Leinka1056/alkine/BOM.md

# alkine - a versatile esp32 dev board – bill of materials

<!-- Generated by Half Life from project cmuv02fvs0c1101sm7iym0ofc. Edits here are overwritten on the next sync. -->
<!-- Generated: 2026-10-11T17:37:29.527Z -->

> [!NOTE]
> This parts list is mirrored from [Half Life](https://halflife.hackclub.com). Editing it here will not change the platform's copy, and the next sync overwrites this file.

| Week | Tier | Parts funding |
| --- | --- | --- |
| Week 1 | Tier 2 | $65.00 |

| Part | What it's for | Qty | Unit | Total | Vendor |
| --- | --- | --- | --- | --- | --- |
| [ESP32-C6-WROOM-1U](https://www.digikey.co.uk/en/products/detail/espressif-systems/ESP32-C6-WROOM-1U-N8/20685870) | main processor | 2 | $5.57 | $11.14 | [digikey](https://www.digikey.co.uk/en/products/detail/espressif-systems/ESP32-C6-WROOM-1U-N8/20685870) |
| [usb c receptacle](https://www.digikey.co.uk/en/products/detail/gct/USB4085-GF-A/9859662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) | usb communication and charging | 2 | $0.91 | $1.82 | [digikey](https://www.digikey.co.uk/en/products/detail/gct/USB4085-GF-A/9859662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) |
| [XC6210B332MR](https://www.digikey.co.uk/en/products/detail/torex-semiconductor-ltd/XC6210B332MR-G/2138119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) | Linear Voltage Regulator IC | 2 | $0.78 | $1.56 | [digikey](https://www.digikey.co.uk/en/products/detail/torex-semiconductor-ltd/XC6210B332MR-G/2138119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) |
| [MCP73871](https://www.digikey.co.uk/en/products/detail/microchip-technology/MCP73871-2CCI-ML/1680971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) | LiPo regulator | 2 | $2.41 | $4.82 | [digikey](https://www.digikey.co.uk/en/products/detail/microchip-technology/MCP73871-2CCI-ML/1680971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) |
| [JS202011AQN](https://www.digikey.co.uk/en/products/detail/c-k/JS202011AQN/1640096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) | fast charge switch | 2 | $0.83 | $1.66 | [digikey](https://www.digikey.co.uk/en/products/detail/c-k/JS202011AQN/1640096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) |
| [CRCW12063K30FKEA](https://www.digikey.co.uk/en/products/detail/vishay-dale/CRCW12063K30FKEA/1176701) | 3.3K OHM resistor(s) | 2 | $0.11 | $0.22 | [digikey](https://www.digikey.co.uk/en/products/detail/vishay-dale/CRCW12063K30FKEA/1176701) |
| [CRCW12065K10FKEA](https://www.digikey.co.uk/en/products/detail/vishay-dale/CRCW12065K10FKEA/1176724) | 5.1K OHM resistor(s) | 4 | $0.11 | $0.44 | [digikey](https://www.digikey.co.uk/en/products/detail/vishay-dale/CRCW12065K10FKEA/1176724) |
| [CRCW12061K00FKEA](https://www.digikey.co.uk/en/products/detail/vishay-dale/CRCW12061K00FKEA/1176644) | 1K OHM resistor(s) | 2 | $0.11 | $0.22 | [digikey](https://www.digikey.co.uk/en/products/detail/vishay-dale/CRCW12061K00FKEA/1176644) |
| [CRCW120610K0FKEA](https://www.digikey.co.uk/en/products/detail/vishay-dale/CRCW120610K0FKEA/1176758) | 10K OHM resistor(s) | 4 | $0.11 | $0.44 | [digikey](https://www.digikey.co.uk/en/products/detail/vishay-dale/CRCW120610K0FKEA/1176758) |
| [CRCW120615K0FKEA](https://www.digikey.co.uk/en/products/detail/vishay-dale/CRCW120615K0FKEA/1176776) | 15K OHM resistor(s) | 4 | $0.11 | $0.44 | [digikey](https://www.digikey.co.uk/en/products/detail/vishay-dale/CRCW120615K0FKEA/1176776) |
| [CRCW12062K00FKEA](https://www.digikey.co.uk/en/products/detail/vishay-dale/CRCW12062K00FKEA/1176676) | 2K OHM resistor(s) | 2 | $0.11 | $0.22 | [digikey](https://www.digikey.co.uk/en/products/detail/vishay-dale/CRCW12062K00FKEA/1176676) |
| [CRCW1206470RFKEA](https://www.digikey.co.uk/en/products/detail/vishay-dale/CRCW1206470RFKEA/1176606) | 470 OHM resistor(s) | 6 | $0.11 | $0.66 | [digikey](https://www.digikey.co.uk/en/products/detail/vishay-dale/CRCW1206470RFKEA/1176606) |
| [298D106X0025A2T](https://www.digikey.co.uk/en/products/detail/vishay-sprague/298D106X0025A2T/21707090) | 10 µF capacitor(s) | 2 | $1.76 | $3.52 | [digikey](https://www.digikey.co.uk/en/products/detail/vishay-sprague/298D106X0025A2T/21707090) |
| [T491A475M016AT](https://www.digikey.co.uk/en/products/detail/kemet/T491A475M016AT/818560) | 4.7 µF capacitor(s) | 6 | $0.64 | $3.84 | [digikey](https://www.digikey.co.uk/en/products/detail/kemet/T491A475M016AT/818560) |
| [T491A226K010AT](https://www.digikey.co.uk/en/products/detail/kemet/T491A226K010AT/2336197) | 22 µF capacitor(s) | 2 | $0.97 | $1.94 | [digikey](https://www.digikey.co.uk/en/products/detail/kemet/T491A226K010AT/2336197) |
| [T491A104K035AT](https://www.digikey.co.uk/en/products/detail/kemet/T491A104K035AT/818537) | 0.1 µF capacitor(s) | 2 | $0.70 | $1.40 | [digikey](https://www.digikey.co.uk/en/products/detail/kemet/T491A104K035AT/818537) |
| [150141M173100](https://www.digikey.co.uk/en/products/detail/w%C3%BCrth-elektronik/150141M173100/4489960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) | bat status led | 2 | $0.50 | $1.00 | [digikey](https://www.digikey.co.uk/en/products/detail/w%C3%BCrth-elektronik/150141M173100/4489960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) |
| [SM1206HC](https://www.digikey.co.uk/en/products/detail/bivar-inc/SM1206HC/3095545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) | pwr flow led | 2 | $0.65 | $1.30 | [digikey](https://www.digikey.co.uk/en/products/detail/bivar-inc/SM1206HC/3095545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) |
| [1N4148W](https://www.digikey.co.uk/en/products/detail/smc-diode-solutions/1N4148W/6022450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) | diode(s) | 2 | $0.15 | $0.30 | [digikey](https://www.digikey.co.uk/en/products/detail/smc-diode-solutions/1N4148W/6022450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) |
| [SM04B-SRSS-TB](https://www.digikey.co.uk/en/products/detail/jst-sales-america-inc/SM04B-SRSS-TB/926710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) | qwiic connectors | 6 | $0.50 | $3.00 | [digikey](https://www.digikey.co.uk/en/products/detail/jst-sales-america-inc/SM04B-SRSS-TB/926710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) |
| [WS2812B](https://www.lcsc.com/product-detail/C114586.html) | general purpose addressable led | 4 | $0.52 | $2.08 | [LCSC](https://www.lcsc.com/product-detail/C114586.html) |
| [S2B-PH-K-S](https://www.digikey.co.uk/en/products/detail/jst-sales-america-inc/S2B-PH-K-S/926626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) | bat connector | 2 | $0.12 | $0.24 | [digikey](https://www.digikey.co.uk/en/products/detail/jst-sales-america-inc/S2B-PH-K-S/926626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) |
| [XUNPU TS-1088R-02026](https://www.lcsc.com/product-detail/C455280.html) | boot and rst buttons | 4 | $0.05 | $0.20 | [LCSC](https://www.lcsc.com/product-detail/C455280.html) |
| [0022052051](https://www.digikey.co.uk/en/products/detail/molex/0022052051/26651) | 5 pin header(s) | 4 | $0.37 | $1.48 | [digikey](https://www.digikey.co.uk/en/products/detail/molex/0022052051/26651) |
| [0022052091](https://www.digikey.co.uk/en/products/detail/molex/0022052091/26659) | 3x9pin bc i cant find 25 pin or more in matching colour. | 6 | $0.79 | $4.74 | [digikey](https://www.digikey.co.uk/en/products/detail/molex/0022052091/26659) |
| **Parts subtotal** | — | — | — | **$48.68** | — |
| **Tax & shipping** | — | — | — | **$0.00** | — |
| **Total** | — | — | — | **$48.68** | — |

$16.32 left of the tier's funding.
