Leinka1056/alkine/1.csv

Reference | Qty | Value | Footprint
C1 | 1 | 10 | Capacitor_Tantalum_SMD:CP_EIA-3216-10_Kemet-I_HandSolder
C2,C3,C4 | 3 | 4.7 | Capacitor_Tantalum_SMD:CP_EIA-3216-10_Kemet-I_HandSolder
C5 | 1 | 22 | Capacitor_Tantalum_SMD:CP_EIA-3216-10_Kemet-I_HandSolder
C6 | 1 | 0.1 | Capacitor_Tantalum_SMD:CP_EIA-3216-10_Kemet-I_HandSolder
D1 | 1 | LED | LED_SMD:LED_RGB_Wuerth-PLCC4_3.2x2.8mm_150141M173100
D2 | 1 | LED | LED_SMD:LED_1206_3216Metric_Pad1.42x1.75mm_HandSolder
D3,D5 | 2 | WS2812B | LED_SMD:LED_WS2812B_PLCC4_5.0x5.0mm_P3.2mm
D4 | 1 | 1N4148W | Diode_SMD:D_SOD-123
ESP32-C6-WROOM-1U? | 1 | ESP32-C6-WROOM-1 | PCM_Espressif:ESP32-C6-WROOM-1U
J1 | 1 | Bat | Connector_JST:JST_PH_S2B-PH-K_1x02_P2.00mm_Horizontal
J2,J9,J10 | 3 | Conn_01x04_Pin | Connector_JST:JST_SH_SM04B-SRSS-TB_1x04-1MP_P1.00mm_Horizontal
J3 | 1 | LED_pins | Connector_PinHeader_1.00mm:PinHeader_1x03_P1.00mm_Horizontal
J4 | 1 | USB_C | Connector_USB:USB_C_Receptacle_GCT_USB4085
J5 | 1 | Conn_GPIO | Connector_PinHeader_2.54mm:PinHeader_1x25_P2.54mm_Horizontal
J6 | 1 | Conn_GND | Connector_PinHeader_2.54mm:PinHeader_1x05_P2.54mm_Horizontal
J7 | 1 | Conn_3V3 | Connector_PinHeader_2.54mm:PinHeader_1x05_P2.54mm_Horizontal
J8 | 1 | Conn_JTAG | Connector_PinHeader_2.54mm:PinHeader_1x04_P2.54mm_Horizontal
J11 | 1 | TH | Connector_JST:JST_PH_S2B-PH-K_1x02_P2.00mm_Horizontal
R1,R2,R3 | 3 | 470 | Resistor_SMD:R_1206_3216Metric_Pad1.30x1.75mm_HandSolder
R4 | 1 | 2k | Resistor_SMD:R_1206_3216Metric_Pad1.30x1.75mm_HandSolder
R5,R7 | 2 | 15k | Resistor_SMD:R_1206_3216Metric_Pad1.30x1.75mm_HandSolder
R6,R11 | 2 | 10k | Resistor_SMD:R_1206_3216Metric_Pad1.30x1.75mm_HandSolder
R8 | 1 | 1k | Resistor_SMD:R_1206_3216Metric_Pad1.30x1.75mm_HandSolder
R9,R10 | 2 | 5.1k | Resistor_SMD:R_1206_3216Metric_Pad1.30x1.75mm_HandSolder
R12 | 1 | 3.3k | Resistor_SMD:R_1206_3216Metric_Pad1.30x1.75mm_HandSolder
SW1,SW2 | 2 | SW_Push | Button_Switch_SMD:SW_SPST_TS-1088-xR025
SW3 | 1 | SW_DPDT_x2 | Button_Switch_THT:SW_CK_JS202011AQN_DPDT_Angled
U2 | 1 | MCP73871 | Package_DFN_QFN:QFN-20-1EP_4x4mm_P0.5mm_EP2.5x2.5mm
U3 | 1 | XC6210B332MR | Package_TO_SOT_SMD:SOT-23-5_HandSoldering
