Leinka1056/alkine/v1/BOM.csv

Item | Qty | Supplier | Cost/item | Total Cost | link
ESP32-C6-WROOM-1U | 2 | digikey | $5.57 | $11.14 | https://www.digikey.co.uk/en/products/detail/espressif-systems/ESP32-C6-WROOM-1U-N8/20685870
usb c receptacle | 2 | digikey | $0.91 | $1.82 | https://www.digikey.co.uk/en/products/detail/gct/USB4085-GF-A/9859662
XC6210B332MR | 2 | digikey | $0.78 | $1.56 | https://www.digikey.co.uk/en/products/detail/torex-semiconductor-ltd/XC6210B332MR-G/2138119
MCP73871 | 2 | digikey | $2.41 | $4.82 | https://www.digikey.co.uk/en/products/detail/microchip-technology/MCP73871-2CCI-ML/1680971
JS202011AQN | 2 | digikey | $0.83 | $1.66 | https://www.digikey.co.uk/en/products/detail/c-k/JS202011AQN/1640096
CRCW12063K30FKEA | 2 | digikey | $0.11 | $0.22 | https://www.digikey.co.uk/en/products/detail/vishay-dale/CRCW12063K30FKEA/1176701
CRCW12065K10FKEA | 4 | digikey | $0.11 | $0.44 | https://www.digikey.co.uk/en/products/detail/vishay-dale/CRCW12065K10FKEA/1176724
CRCW12061K00FKEA | 2 | digikey | $0.11 | $0.22 | https://www.digikey.co.uk/en/products/detail/vishay-dale/CRCW12061K00FKEA/1176644
CRCW120610K0FKEA | 4 | digikey | $0.11 | $0.44 | https://www.digikey.co.uk/en/products/detail/vishay-dale/CRCW120610K0FKEA/1176758
CRCW120615K0FKEA | 4 | digikey | $0.11 | $0.44 | https://www.digikey.co.uk/en/products/detail/vishay-dale/CRCW120615K0FKEA/1176776
CRCW12062K00FKEA | 2 | digikey | $0.11 | $0.22 | https://www.digikey.co.uk/en/products/detail/vishay-dale/CRCW12062K00FKEA/1176676
CRCW1206470RFKEA | 6 | digikey | $0.11 | $0.66 | https://www.digikey.co.uk/en/products/detail/vishay-dale/CRCW1206470RFKEA/1176606
298D106X0025A2T | 2 | digikey | $1.76 | $3.52 | https://www.digikey.co.uk/en/products/detail/vishay-sprague/298D106X0025A2T/21707090
T491A475M016AT | 6 | digikey | $0.64 | $3.84 | https://www.digikey.co.uk/en/products/detail/kemet/T491A475M016AT/818560
T491A226K010AT | 2 | digikey | $0.97 | $1.94 | https://www.digikey.co.uk/en/products/detail/kemet/T491A226K010AT/2336197
T491A104K035AT | 2 | digikey | $0.70 | $1.40 | https://www.digikey.co.uk/en/products/detail/kemet/T491A104K035AT/818537
150141M173100 | 2 | digikey | $0.50 | $1.00 | https://www.digikey.co.uk/en/products/detail/w%C3%BCrth-elektronik/150141M173100/4489960
SM1206HC | 2 | digikey | $0.65 | $1.30 | https://www.digikey.co.uk/en/products/detail/bivar-inc/SM1206HC/3095545
1N4148W | 2 | digikey | $0.15 | $0.30 | https://www.digikey.co.uk/en/products/detail/smc-diode-solutions/1N4148W/6022450
SM04B-SRSS-TB | 6 | digikey | $0.50 | $3.00 | https://www.digikey.co.uk/en/products/detail/jst-sales-america-inc/SM04B-SRSS-TB/926710
WS2812B | 4 | LCSC | $0.52 | $2.08 | https://www.lcsc.com/product-detail/C114586.html
S2B-PH-K-S | 2 | digikey | $0.12 | $0.24 | https://www.digikey.co.uk/en/products/detail/jst-sales-america-inc/S2B-PH-K-S/926626
XUNPU TS-1088R-02026 | 4 | LCSC | $0.05 | $0.20 | https://www.lcsc.com/product-detail/C455280.html
0022052051 | 4 | digikey | $0.37 | $1.48 | https://www.digikey.co.uk/en/products/detail/molex/0022052051/26651
0022052091 | 6 | digikey | $0.79 | $4.74 | https://www.digikey.co.uk/en/products/detail/molex/0022052091/26659
Estimated total shipping | 1 |  |  | $0.00
