Leinka1056/alkine/v1/pcb/1.kicad_pcb

## KiCad design v1/pcb/1.kicad_pcb (2026-10-10)

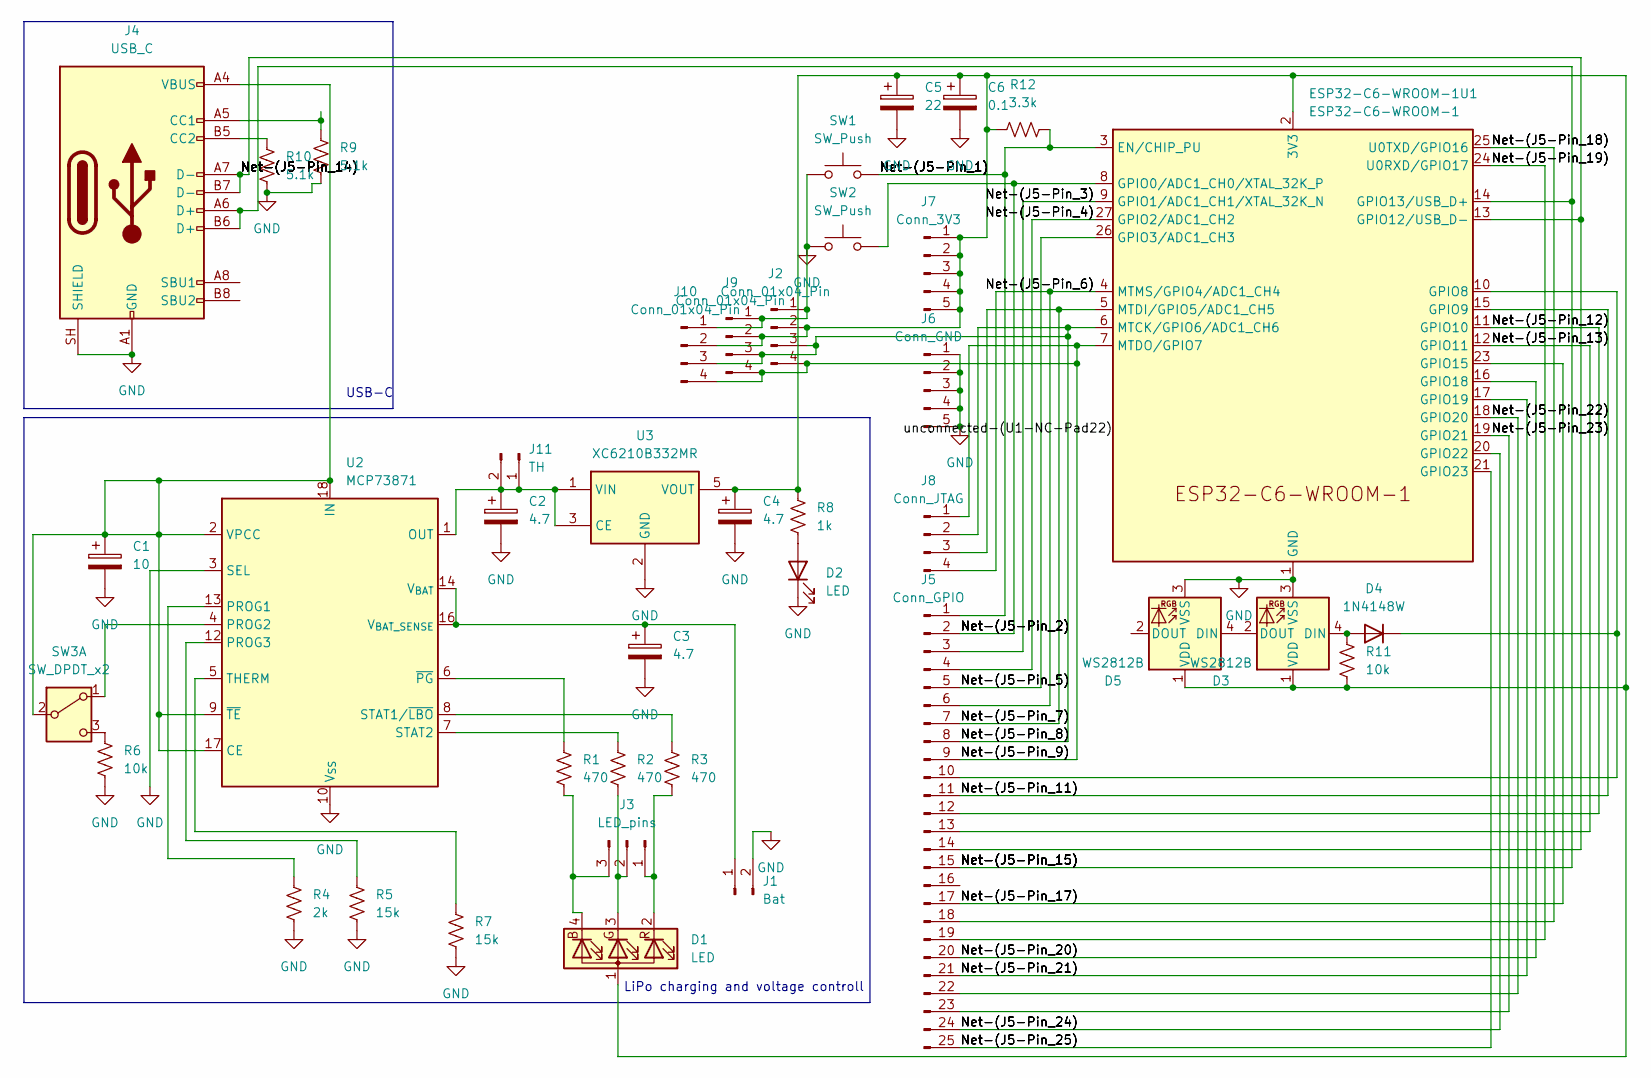
[picture p1: schematic 1.kicad_sch, alkine 1]

Parts:
C1: 10; CP_EIA-3216-10_Kemet-I_HandSolder
C2, C3, C4: 4.7; CP_EIA-3216-10_Kemet-I_HandSolder
C5: 22; CP_EIA-3216-10_Kemet-I_HandSolder
C6: 0.1; CP_EIA-3216-10_Kemet-I_HandSolder
D1: LED; LED_RGB_Wuerth-PLCC4_3.2x2.8mm_150141M173100
D2: LED; LED_1206_3216Metric_Pad1.42x1.75mm_HandSolder
D3, D5: WS2812B; LED_WS2812B_PLCC4_5.0x5.0mm_P3.2mm
D4: 1N4148W; D_SOD-123
ESP32-C6-WROOM-1U1: ESP32-C6-WROOM-1; ESP32-C6-WROOM-1U
J1: Bat; JST_PH_S2B-PH-K_1x02_P2.00mm_Horizontal
J2, J9, J10: Conn_01x04_Pin; JST_SH_SM04B-SRSS-TB_1x04-1MP_P1.00mm_Horizontal
J3: LED_pins; PinHeader_1x03_P1.00mm_Horizontal
J4: USB_C; USB_C_Receptacle_GCT_USB4085
J5: Conn_GPIO; PinHeader_1x25_P2.54mm_Horizontal
J6: Conn_GND; PinHeader_1x05_P2.54mm_Horizontal
J7: Conn_3V3; PinHeader_1x05_P2.54mm_Horizontal
J8: Conn_JTAG; PinHeader_1x04_P2.54mm_Horizontal
J11: TH; JST_PH_S2B-PH-K_1x02_P2.00mm_Horizontal
R1, R2, R3: 470; R_1206_3216Metric_Pad1.30x1.75mm_HandSolder
R4: 2k; R_1206_3216Metric_Pad1.30x1.75mm_HandSolder
R5, R7: 15k; R_1206_3216Metric_Pad1.30x1.75mm_HandSolder
R6, R11: 10k; R_1206_3216Metric_Pad1.30x1.75mm_HandSolder
R8: 1k; R_1206_3216Metric_Pad1.30x1.75mm_HandSolder
R9, R10: 5.1k; R_1206_3216Metric_Pad1.30x1.75mm_HandSolder
R12: 3.3k; R_1206_3216Metric_Pad1.30x1.75mm_HandSolder
SW1, SW2: SW_Push; SW_SPST_TS-1088-xR025
SW3: SW_DPDT_x2; SW_CK_JS202011AQN_DPDT_Angled
U2: MCP73871; QFN-20-1EP_4x4mm_P0.5mm_EP2.5x2.5mm
U3: XC6210B332MR; SOT-23-5_HandSoldering

Connections:
/Net-(J5-Pin_1): ESP32-C6-WROOM-1U1.3 (EN/CHIP_PU), J5.1, R12.2, SW1.2; also elsewhere on the board
/Net-(J5-Pin_2): ESP32-C6-WROOM-1U1.8 (GPIO0/ADC1_CH0/XTAL_32K_P), J5.2, SW2.2; also elsewhere on the board
/Net-(J5-Pin_3): ESP32-C6-WROOM-1U1.9 (GPIO1/ADC1_CH1/XTAL_32K_N), J5.3; also elsewhere on the board
/Net-(J5-Pin_4): ESP32-C6-WROOM-1U1.27 (GPIO2/ADC1_CH2), J5.4; also elsewhere on the board
/Net-(J5-Pin_5): ESP32-C6-WROOM-1U1.26 (GPIO3/ADC1_CH3), J5.5; also elsewhere on the board
/Net-(J5-Pin_6): ESP32-C6-WROOM-1U1.4 (MTMS/GPIO4/ADC1_CH4), J5.6, J8.4; also elsewhere on the board
/Net-(J5-Pin_7): ESP32-C6-WROOM-1U1.5 (MTDI/GPIO5/ADC1_CH5), J5.7, J8.3; also elsewhere on the board
/Net-(J5-Pin_8): ESP32-C6-WROOM-1U1.6 (MTCK/GPIO6/ADC1_CH6), J2.3, J5.8, J8.2, J9.3, J10.3; also elsewhere on the board
/Net-(J5-Pin_9): ESP32-C6-WROOM-1U1.7 (MTDO/GPIO7), J2.4, J5.9, J8.1, J9.4, J10.4; also elsewhere on the board
/Net-(J5-Pin_11): ESP32-C6-WROOM-1U1.15 (GPIO9), J5.11; also elsewhere on the board
/Net-(J5-Pin_12): ESP32-C6-WROOM-1U1.11 (GPIO10), J5.12; also elsewhere on the board
/Net-(J5-Pin_13): ESP32-C6-WROOM-1U1.12 (GPIO11), J5.13; also elsewhere on the board
/Net-(J5-Pin_14): ESP32-C6-WROOM-1U1.13 (GPIO12/USB_D-), J4.A7 (D-), J4.B7 (D-), J5.14; also elsewhere on the board
/Net-(J5-Pin_15): ESP32-C6-WROOM-1U1.14 (GPIO13/USB_D+), J4.A6 (D+), J4.B6 (D+), J5.15; also elsewhere on the board
/Net-(J5-Pin_17): ESP32-C6-WROOM-1U1.23 (GPIO15), J5.17; also elsewhere on the board
/Net-(J5-Pin_18): ESP32-C6-WROOM-1U1.25 (U0TXD/GPIO16), J5.18; also elsewhere on the board
/Net-(J5-Pin_19): ESP32-C6-WROOM-1U1.24 (U0RXD/GPIO17), J5.19; also elsewhere on the board
/Net-(J5-Pin_20): ESP32-C6-WROOM-1U1.16 (GPIO18), J5.20; also elsewhere on the board
/Net-(J5-Pin_21): ESP32-C6-WROOM-1U1.17 (GPIO19), J5.21; also elsewhere on the board
/Net-(J5-Pin_22): ESP32-C6-WROOM-1U1.18 (GPIO20), J5.22; also elsewhere on the board
/Net-(J5-Pin_23): ESP32-C6-WROOM-1U1.19 (GPIO21), J5.23; also elsewhere on the board
/Net-(J5-Pin_24): ESP32-C6-WROOM-1U1.20 (GPIO22), J5.24; also elsewhere on the board
/Net-(J5-Pin_25): ESP32-C6-WROOM-1U1.21 (GPIO23), J5.25; also elsewhere on the board
GND: C1.2, C2.2, C3.2, C4.2, C5.2, C6.2, D2.1 (K), D3.3 (VSS), D5.3 (VSS), ESP32-C6-WROOM-1U1.1 (GND), ESP32-C6-WROOM-1U1.28 (GND), ESP32-C6-WROOM-1U1.29 (GND), J1.2, J2.1, J4.A1 (GND), J4.A12 (GND), J4.B1 (GND), J4.B12 (GND), J4.SH (SHIELD), J6.1, J6.2, J6.3, J6.4, J6.5, J9.1, J10.1, R4.2, R5.2, R6.2, R7.2, R9.2, R10.2, SW1.1, SW2.1, U2.3 (SEL), U2.10 (V_{SS}), U2.11 (V_{SS}), U2.21 (V_{SS}), U3.2 (GND); also elsewhere on the board
unnamed 24: C4.1, C5.1, C6.1, D1.1 (A), D3.1 (VDD), D5.1 (VDD), ESP32-C6-WROOM-1U1.2 (3V3), J2.2, J7.1, J7.2, J7.3, J7.4, J7.5, J9.2, J10.2, R8.1, R11.2, R12.1, U3.5 (VOUT); also elsewhere on the board
unnamed: D1.4 (BK), J3.3, R1.2
unnamed: D1.3 (GK), J3.2, R2.2
unnamed: D1.2 (RK), J3.1, R3.2
unnamed: D2.2 (A), R8.2
unnamed: D3.4 (DIN), D4.2 (A), R11.1
unnamed: D3.2 (DOUT), D5.4 (DIN)
unnamed 31: D4.1 (K), ESP32-C6-WROOM-1U1.10 (GPIO8), J5.10; also elsewhere on the board
unnamed: C3.1, J1.1, U2.14 (V_{BAT}), U2.15 (V_{BAT}), U2.16 (V_{BAT_SENSE})
unnamed: J4.A5 (CC1), R9.1
unnamed: J4.B5 (CC2), R10.1
unnamed: C2.1, J11.1, J11.2, U2.1 (OUT), U2.20 (OUT), U3.1 (VIN), U3.3 (CE)
unnamed: SW3.1 (A), U2.4 (PROG2)
unnamed: C1.1, J4.A4 (VBUS), J4.A9 (VBUS), J4.B4 (VBUS), J4.B9 (VBUS), SW3.2 (B), U2.2 (VPCC), U2.9 (~TE), U2.17 (CE), U2.18 (IN), U2.19 (IN)
unnamed: R6.1, SW3.3 (C)
unnamed: R4.1, U2.13 (PROG1)
unnamed: R5.1, U2.12 (PROG3)
unnamed: R3.1, U2.8 (STAT1/~LBO)
unnamed: R2.1, U2.7 (STAT2)
unnamed: R7.1, U2.5 (THERM)
unnamed: R1.1, U2.6 (~PG)

Notes on the sheet:
LiPo charging and voltage controll
USB-C

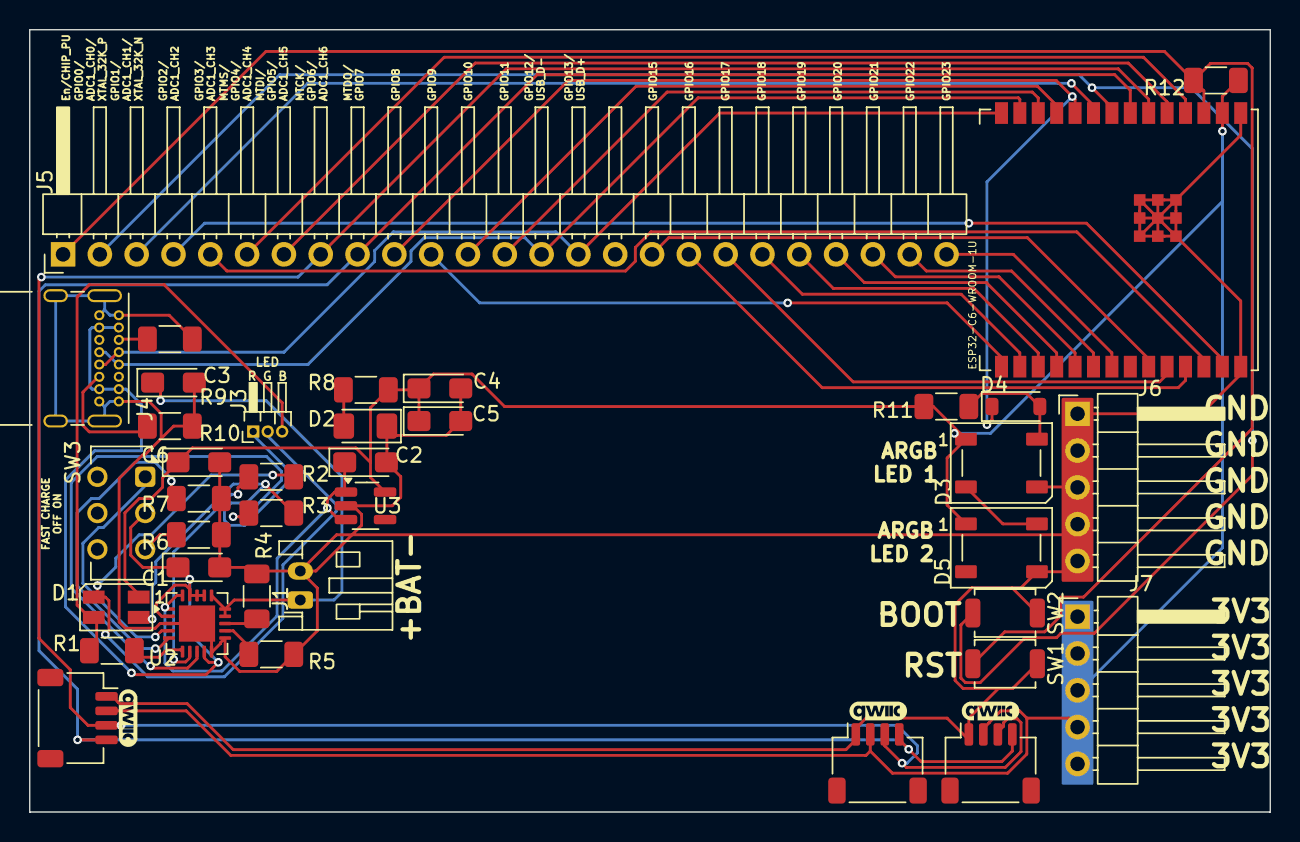
[picture p2: board 1.kicad_pcb from above]

Board: 2 copper layers, 85.6 x 54.0 mm, 38 parts (0 on the bottom side), 45 nets.

Other parts of the board:
ESP32-C6-WROOM-1U: ESP32-C6-WROOM-1; ESP32-C6-WROOM-1U

Their connections:
/Net-(J5-Pin_1): ESP32-C6-WROOM-1U.3 (EN/CHIP_PU); also elsewhere on the board
/Net-(J5-Pin_2): ESP32-C6-WROOM-1U.8 (GPIO0/ADC1_CH0/XTAL_32K_P); also elsewhere on the board
/Net-(J5-Pin_3): ESP32-C6-WROOM-1U.9 (GPIO1/ADC1_CH1/XTAL_32K_N); also elsewhere on the board
/Net-(J5-Pin_4): ESP32-C6-WROOM-1U.27 (GPIO2/ADC1_CH2); also elsewhere on the board
/Net-(J5-Pin_5): ESP32-C6-WROOM-1U.26 (GPIO3/ADC1_CH3); also elsewhere on the board
/Net-(J5-Pin_6): ESP32-C6-WROOM-1U.4 (MTMS/GPIO4/ADC1_CH4); also elsewhere on the board
/Net-(J5-Pin_7): ESP32-C6-WROOM-1U.5 (MTDI/GPIO5/ADC1_CH5); also elsewhere on the board
/Net-(J5-Pin_8): ESP32-C6-WROOM-1U.6 (MTCK/GPIO6/ADC1_CH6); also elsewhere on the board
/Net-(J5-Pin_9): ESP32-C6-WROOM-1U.7 (MTDO/GPIO7); also elsewhere on the board
/Net-(J5-Pin_11): ESP32-C6-WROOM-1U.15 (GPIO9); also elsewhere on the board
/Net-(J5-Pin_12): ESP32-C6-WROOM-1U.11 (GPIO10); also elsewhere on the board
/Net-(J5-Pin_13): ESP32-C6-WROOM-1U.12 (GPIO11); also elsewhere on the board
/Net-(J5-Pin_14): ESP32-C6-WROOM-1U.13 (GPIO12/USB_D-); also elsewhere on the board
/Net-(J5-Pin_15): ESP32-C6-WROOM-1U.14 (GPIO13/USB_D+); also elsewhere on the board
/Net-(J5-Pin_17): ESP32-C6-WROOM-1U.23 (GPIO15); also elsewhere on the board
/Net-(J5-Pin_18): ESP32-C6-WROOM-1U.25 (U0TXD/GPIO16); also elsewhere on the board
/Net-(J5-Pin_19): ESP32-C6-WROOM-1U.24 (U0RXD/GPIO17); also elsewhere on the board
/Net-(J5-Pin_20): ESP32-C6-WROOM-1U.16 (GPIO18); also elsewhere on the board
/Net-(J5-Pin_21): ESP32-C6-WROOM-1U.17 (GPIO19); also elsewhere on the board
/Net-(J5-Pin_22): ESP32-C6-WROOM-1U.18 (GPIO20); also elsewhere on the board
/Net-(J5-Pin_23): ESP32-C6-WROOM-1U.19 (GPIO21); also elsewhere on the board
/Net-(J5-Pin_24): ESP32-C6-WROOM-1U.20 (GPIO22); also elsewhere on the board
/Net-(J5-Pin_25): ESP32-C6-WROOM-1U.21 (GPIO23); also elsewhere on the board
GND: ESP32-C6-WROOM-1U.1 (GND), ESP32-C6-WROOM-1U.28 (GND), ESP32-C6-WROOM-1U.29 (GND); also elsewhere on the board
unnamed 24: ESP32-C6-WROOM-1U.2 (3V3); also elsewhere on the board
unnamed 31: ESP32-C6-WROOM-1U.10 (GPIO8); also elsewhere on the board
