Leinka1056/alkine/JOURNAL.md

# alkine - a versatile esp32 dev board – devlog

<!-- Generated by Half Life from project cmuv02fvs0c1101sm7iym0ofc. Edits here are overwritten on the next sync. -->
<!-- Generated: 2026-10-10T15:58:03.343Z -->

> [!NOTE]
> This devlog is mirrored from [Half Life](https://halflife.hackclub.com). Editing it here will not change the platform's copy, and the next sync overwrites this file.

> my first complicated pcb, i want to make an esp32 based dev board for many future projects i am thinking up.

| Week | Tier | Hours logged | Entries |
| --- | --- | --- | --- |
| Week 1 | Tier 2 | 26.04h | 9 |

## Contents

1. [2026-10-05 – # prep work:](#2026-10-05-prep-work)
2. [2026-10-05 – # Researching esp32 options](#2026-10-05-researching-esp32-options)
3. [2026-10-06 – # Finding info and kicad files](#2026-10-06-finding-info-and-kicad-files)
4. [2026-10-06 – # started working on peripherals on the schematic](#2026-10-06-started-working-on-peripherals-on-the-schematic)
5. [2026-10-06 – Work session](#2026-10-06-work-session)
6. [2026-10-07 – the tab with lapse crashed, but i checked a few minutes before hand so the time is accurate (i paused for all the brakes i took), but i cant go into as much detail on what i did as i wasn't making not](#2026-10-07-the-tab-with-lapse-crashed-but-i-checked-a-few-mi)
7. [2026-10-09 – Work session](#2026-10-09-work-session)
8. [2026-10-09 – Work session](#2026-10-09-work-session)
9. [2026-10-10 – Work session](#2026-10-10-work-session)

## Design

### 2026-10-05 – # prep work:

**1h**

# prep work:
## accomplished:
(technically yesterday)
- Made the intro video. (didnt count time)
This includes a script (image below), background footage, recording and editing.
- installed the needed apps.
Some random audio recorder (didnt count time) for the video, kdenlive (didnt count time) for the video editing, kicad for pcb making,which i will do tomorrow*.

Ive never used kden live before ;-;
Cant wait to use another app ive never used before tomorrow* (kicad)

*ik its technically today but...

## time/process breakdown:

planning
(no image)


writing (didnt count time)


reading (didnt count time)

Screenshot from 2026-10-06 00-02-06
recording (didnt count time)

Screenshot from 2026-10-05 23-58-55
editing (didnt count time)

.

yes i wrote the script on a typewriter

.

.

:3

### 2026-10-05 – # Researching esp32 options

**2h**

# Researching esp32 options
## accomplished:
- found best currently stocked `ESP32` module to use.

## time/process breakdown:
**10 minutes in:** found a comparison sheet for what looks like every ` esp32`, [here](https://products.espressif.com/api/user/file/Espressif_SoC_Product_Portfolio.pdf) (screenshot below)


**23 minutes in: **will go with a module, not a lone soc to avoid needing more circuitry

**41 minutes in: **after narrowing down the options by removing choices with no wifi or only 1 I2C connection, i will likely be going with the ` ESP32-S31`  of some kind, it looks to be the most powerful and versatile



**45 minutes in: **almost certainly using the ` ESP32-S31`. Will find somewhere to purchase it and find the best variation/ module  next.


**48 minutes in: **the non-soc options are either `ESP32-S31-WROOM-1` or `-ESP32-S31-WROOM-3` (preferably want the U versions,  as they have an antenna connector rather than built in pcb antenna)

**52 minutes in: **` ESP32-S31-WROOM-1U` is **not** smd and is also smaller, this is better as I can fit more on the pcb and also hand solder more parts easier.

**60 minutes in:** Did not find `ESP32-S31-WROOM-1U` for sale, will go with `ESP32-S31-WROOM-1` instead (pcb antenna rather than connector)
[digekey uk](https://www.digikey.co.uk/en/products/detail/espressif-systems/ESP32-S31-WROOM-1-N16R16V)

The rest of the time was been spent going over all of my notes to make sure everything checks out along with accumulating all notes and pictures into one place and writing it neatly with rich text (so cool).

.

.

:3

### 2026-10-06 – # Finding info and kicad files

**2h**

# Finding info and kicad files
## accomplished:
- chose different `ESP32` board as the `ESP32-S31` lacks community support
-  found espressif library

## time/process breakdown:
started: 9:00, ended: 10:55

**9:05:** looking for `ESP32-S31` files for kicad, also lacks support for
circuitpython.

**9:55:** did not find `ESP32-S31` files for kicad. Did find a lot of complexity and a lack of support, will decide on a different module.

**10:00:** taking a break.

**10:15:** break over.

**10:20:** best option seems to be either the `ESP32-C6-WROOM-1U` or the `ESP32-C5-WROOM-1U` (it also means i can have an antenna connector rather than a pc antenna!)


**10:25:** i will go with `ESP32-C6-WROOM-1U` as the only upside of the `ESP32-C5-WROOM-1U` that i can understand is dual band wifi. the `ESP32-C6-WROOM-1U` has a higher max operating temp and more pins too. i have chosen the `ESP32-C6-WROOM-1U` as it has castelated solder pads rather than smd along with the formerly mentoned antenna connector. i will now try and find a place to buy it

**10:30:** the best option i can find is the `ESP32-C6-WROOM-1U-N8` option (`N8` meaning 8mb of flash mem) on digikey, [here](https://www.digikey.co.uk/en/products/detail/espressif-systems/ESP32-C6-WROOM-1U-N8/20685870)


**10:55**: cant install library, stopping for now.

.

.

:3

### 2026-10-06 – # started working on peripherals on the schematic

**2.3h**

# started working on peripherals on the schematic
## accomplished:
- chose to use a `ESP32-C6` module as the `ESP32-S31` lacks community support
- researched lipo battery circuitry
- researched usb c circuitry

## time/process breakdown:
started: 01:20(pm), ended: 04:50(pm)
time taken: approx 2h 15m

**01:26;** switched to upto-date kicad, looking for how to get the `ESP32-C6-WROOM-1U` to actually appear

**02:00:** taking a break
**02:30:** break over

**02:43:** got oficiall espressif lib to start working... (idk how tbh)

**02:50:** another break
**03:15:** break over

**03:16:** researching how to wire it up to other things
batt2

**04:09:** will use the [`MCP73871`](https://ww1.microchip.com/downloads/en/DeviceDoc/MCP73871-Data-Sheet-20002090E.pdf) ic for battery management.
the diagram im using

**04:37:** i found a neat diagram for peripherals on the [`ESP32-C6-WROOM-1` & `ESP32-C6-WROOM-1U` datasheet](https://documentation.espressif.com/esp32-c6-wroom-1_wroom-1u_datasheet_en.html#module_schematics)
peripherals

**04:50:** stopping now

### 2026-10-06 – Work session

**1.28h**

[Timelapse](https://lookout.hackclub.com/api/media/537ec7d1-bc0f-4763-ad8b-17adbd6efa00/video.mp4)

### 2026-10-07 – the tab with lapse crashed, but i checked a few minutes before hand so the time is accurate (i paused for all the brakes i took), but i cant go into as much detail on what i did as i wasn't making not

**3.7h**

the tab with lapse crashed, but i checked a few minutes before hand so the time is accurate (i paused for all the brakes i took), but i cant go into as much detail on what i did as i wasn't making notes
# working on the schematic
## accomplished:
- finished making part of schematic for r`MCP73871` and accompanying circuitry

## time/process breakdown:
started: [unknown]pm, finished: 6:22
[unknown]

i was mostly following [this](https://www.instructables.com/How-to-Bring-USB-Rechargeable-LiPo-Power-to-Your-C/) guide, i still need to make sure only 3.3v is going to the `ESP32` tho

i couldn't work out the capacitors but i paused it for however long i was asking for help as i didn't want to show any of my discord contacts' info, it was a while tho... oh well.
caps

i am trying to add a lot of extra headers for adding to or modifying some of the functionaliy, eg the leds have headers for if i want to feed the info into the `ESP32`

leds
i also have a fast charge toggle (for batteries that can handle it) and a switch to enable the thermister by switching it from a no-variable resistor to a header for adding a thermister and resistors to controll it
sw1
sw2

current schematic:
Screenshot from 2026-10-07 18-28-00

### 2026-10-09 – Work session

**0.93h**

[Timelapse](https://lookout.hackclub.com/api/media/9e5fc2e8-6088-4f82-9217-c942ae8c5c4b/video.mp4)

### 2026-10-09 – Work session

**11.1h**

[Timelapse](https://lookout.hackclub.com/api/media/d7888b16-af61-42ed-a4cc-9a25577696ec/video.mp4)

### 2026-10-10 – Work session

**1.73h**

[Timelapse](https://lookout.hackclub.com/api/media/08f777bc-29ba-42d8-b075-eff92f11dad0/video.mp4)
