Leinka1056/alkine/(commit log)

2026-10-05 Sync alkine - a versatile esp32 dev board from Half Life
2026-10-10 v1
    uuh.... the v1 pcb and schematic ig
    [1.kicad_pcb, 1.kicad_sch]
2026-10-11 gerber n stuff
2026-10-19 Update README.md
    Added bom
